nayanpat/ECE-544-Mobile-Robots-Projects/Project Deliverables/robot photos/IMG-4118.jpg

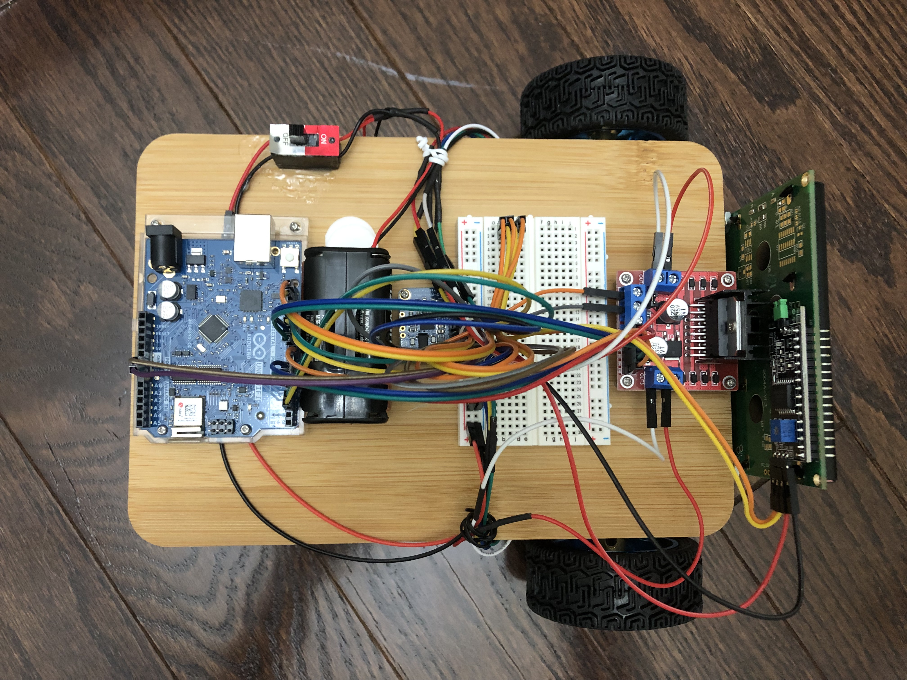
Project Deliverables/robot photos/IMG-4118.jpg
