nayanpat/ECE-544-Mobile-Robots-Projects/Supporting Materials/Example Code/Arduino_LSM6DS3-1.0.2/README.adoc

:repository-owner: arduino-libraries
:repository-name: Arduino_LSM6DS3

= {repository-name} Library for Arduino =





Allows you to read the accelerometer and gyroscope values from the LSM6DS3 IMU on your Arduino Nano 33 IoT or Arduino Uno WiFi Rev2 boards.

For more information about this library please visit us at https://www.arduino.cc/reference/en/libraries/arduino_lsm6ds3/
