nayanpat/ECE-544-Mobile-Robots-Projects/Project Deliverables/robot photos/IMG-4116.jpg

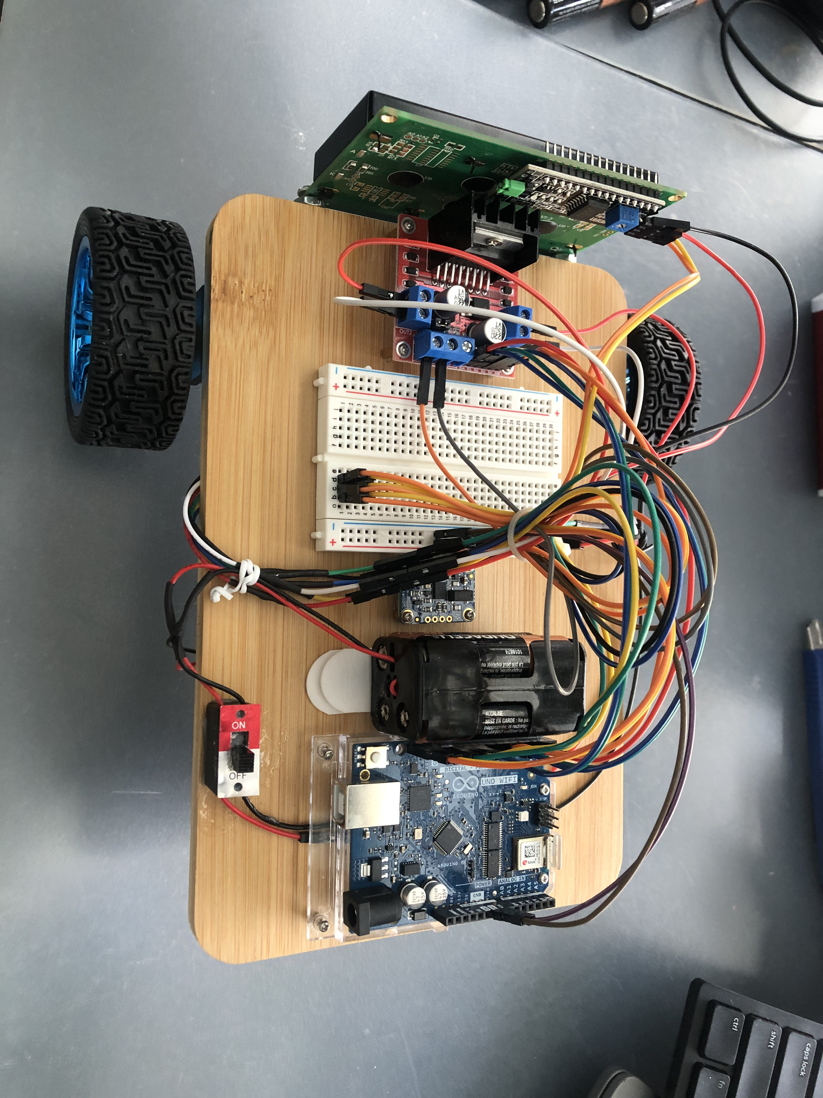
Project Deliverables/robot photos/IMG-4116.jpg
