nayanpat/ECE-544-Mobile-Robots-Projects/Project Deliverables/ECE544_Project_NayanPatel_CodeFiles/ECE544_DiffDrive/Inverse_Kinematics.h

#include <Arduino.h>
#include "Feedback_Controller.h"

#ifdef __cplusplus
 extern "C" {
#endif

typedef struct 
{
  float wheelSpeedLeft;
  float wheelSpeedRight;
}wheelSpeedCommand;

extern wheelSpeedCommand calWheelSpeed(refVelocity refVelVals);

#ifdef __cplusplus
}
#endif
