nayanpat/ECE-544-Mobile-Robots-Projects/(commit log)

2026-03-05 Adding all the project files/folders
    [rpm_vs_pwm.xlsx]
2026-03-05 Track files in git instead of LFS
    [rpm_vs_pwm.xlsx]
2026-03-05 Pushing changes after untracking via LFS
    [rpm_vs_pwm.xlsx]
2026-03-05 Track MOV files with Git LFS
2026-03-05 Convert raspberry-pi-baremetal-c from submodule to regular directory
2026-03-05 Replace gitlinks with actual folder contents
    [dma_pwm_pulse_width_calculator.xlsx]
2026-03-05 Restructured Project Deliverables and Supporting Materials
    [dma_pwm_pulse_width_calculator.xlsx, rpm_vs_pwm.xlsx]
